Brunner-neutrino-lab/VUV4-carrier/pcb/vuv4x2/vuv4x3.step

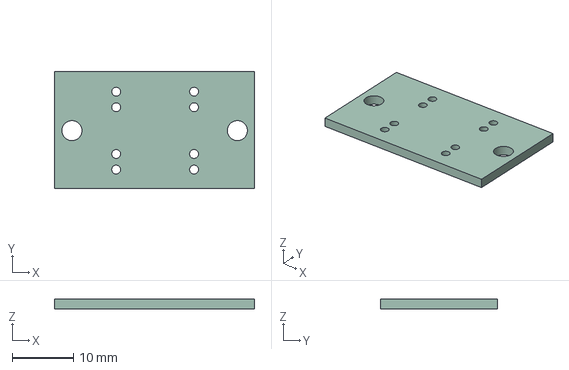
[picture p1: CAD file, 2023-06-26]
pcb/vuv4x2/vuv4x3.step
32.6 x 19.0 x 1.58 mm
