Brunner-neutrino-lab/VUV4-carrier/pcb/vuv4x2/vuv4x2.step

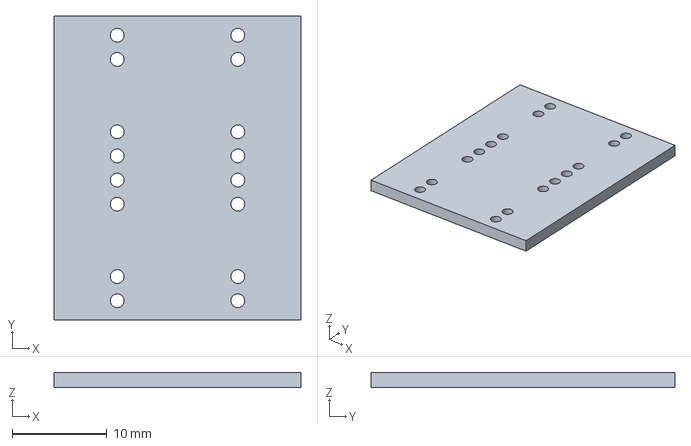
[picture p2: CAD file, 2023-05-21]
pcb/vuv4x2/vuv4x2.step
26.0 x 32.0 x 1.60 mm
