Brunner-neutrino-lab/VUV4-carrier/parts/Adam Tech MMCX SMT RF20-01B-L-00-50-G-TR.pdf

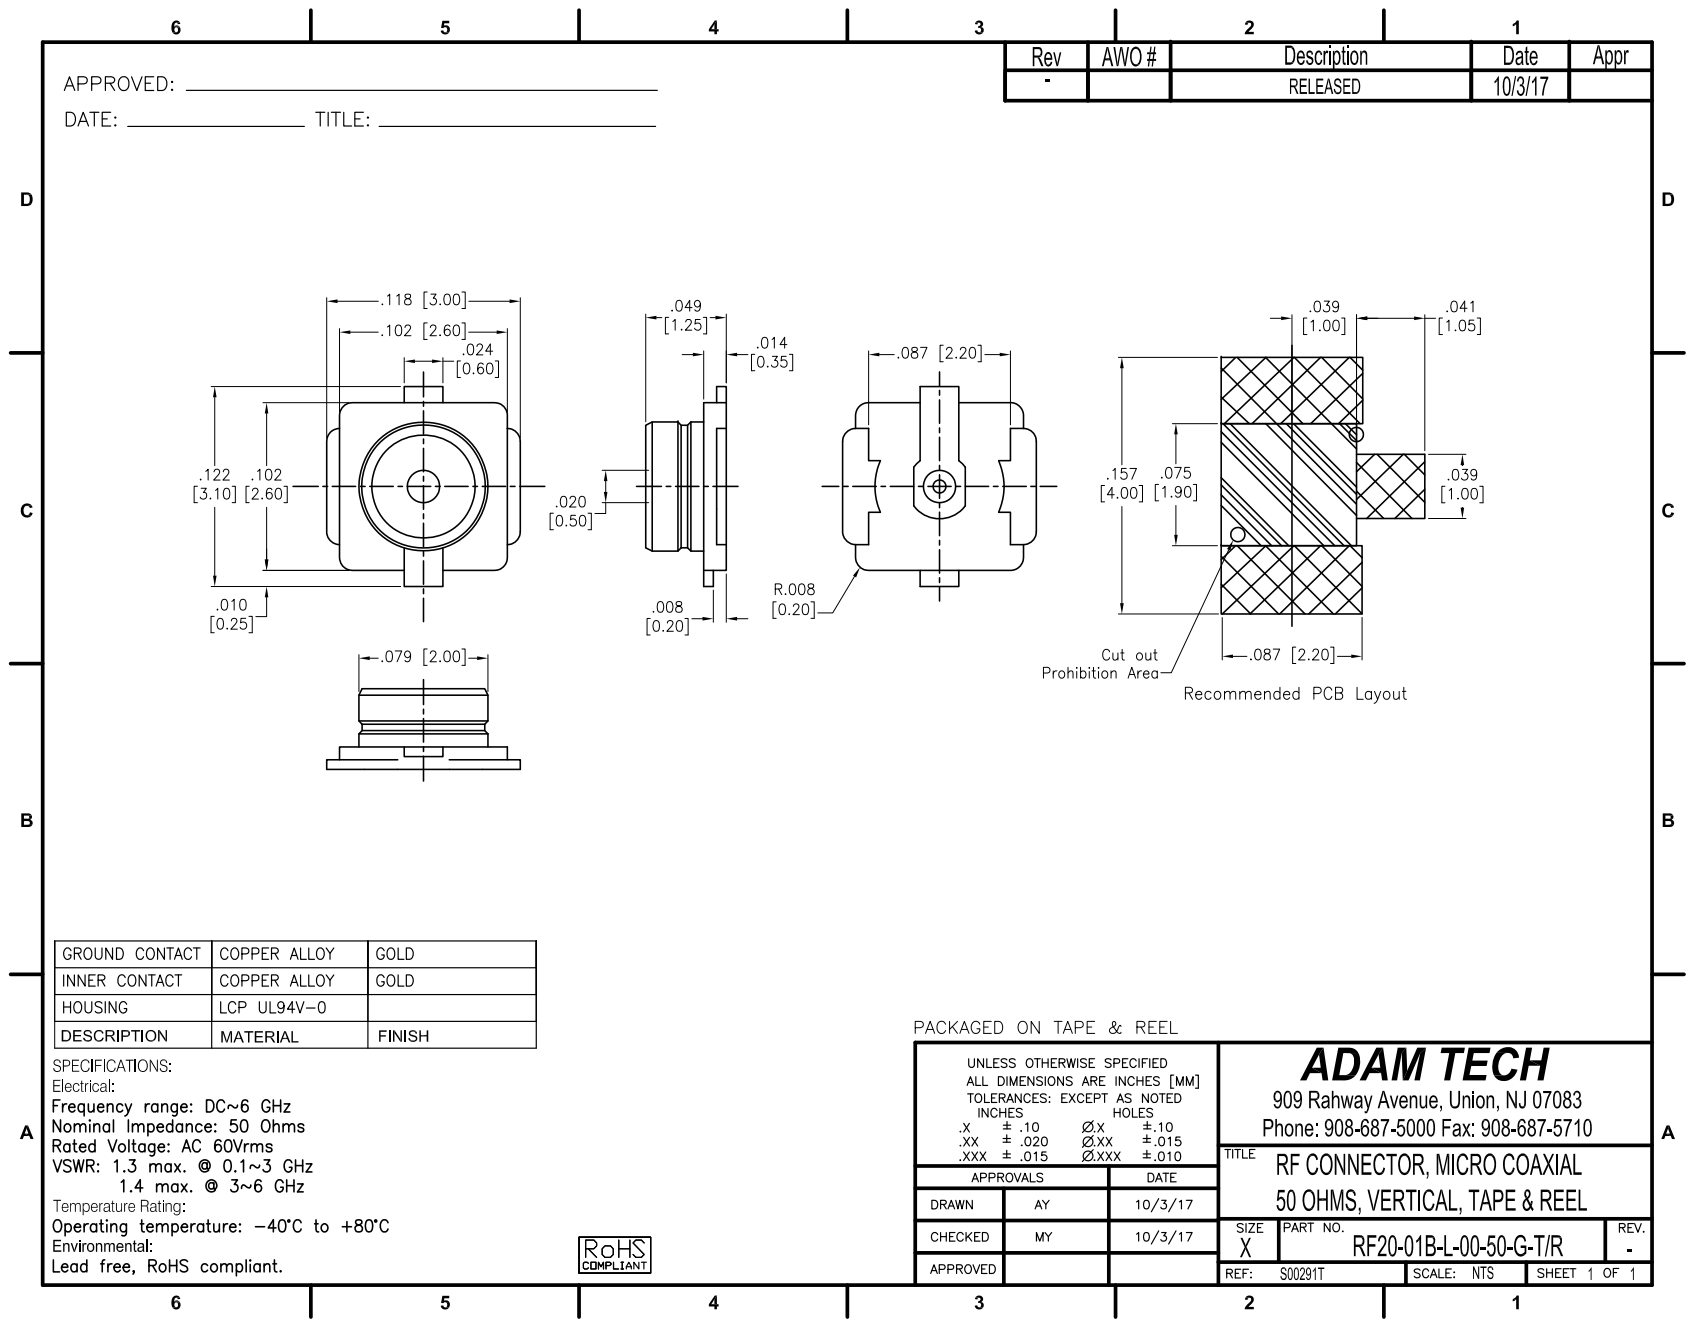
[picture p3: page 1]
