Brunner-neutrino-lab/VUV4-carrier/parts/Molex MMCX THT 734151472_sd.pdf

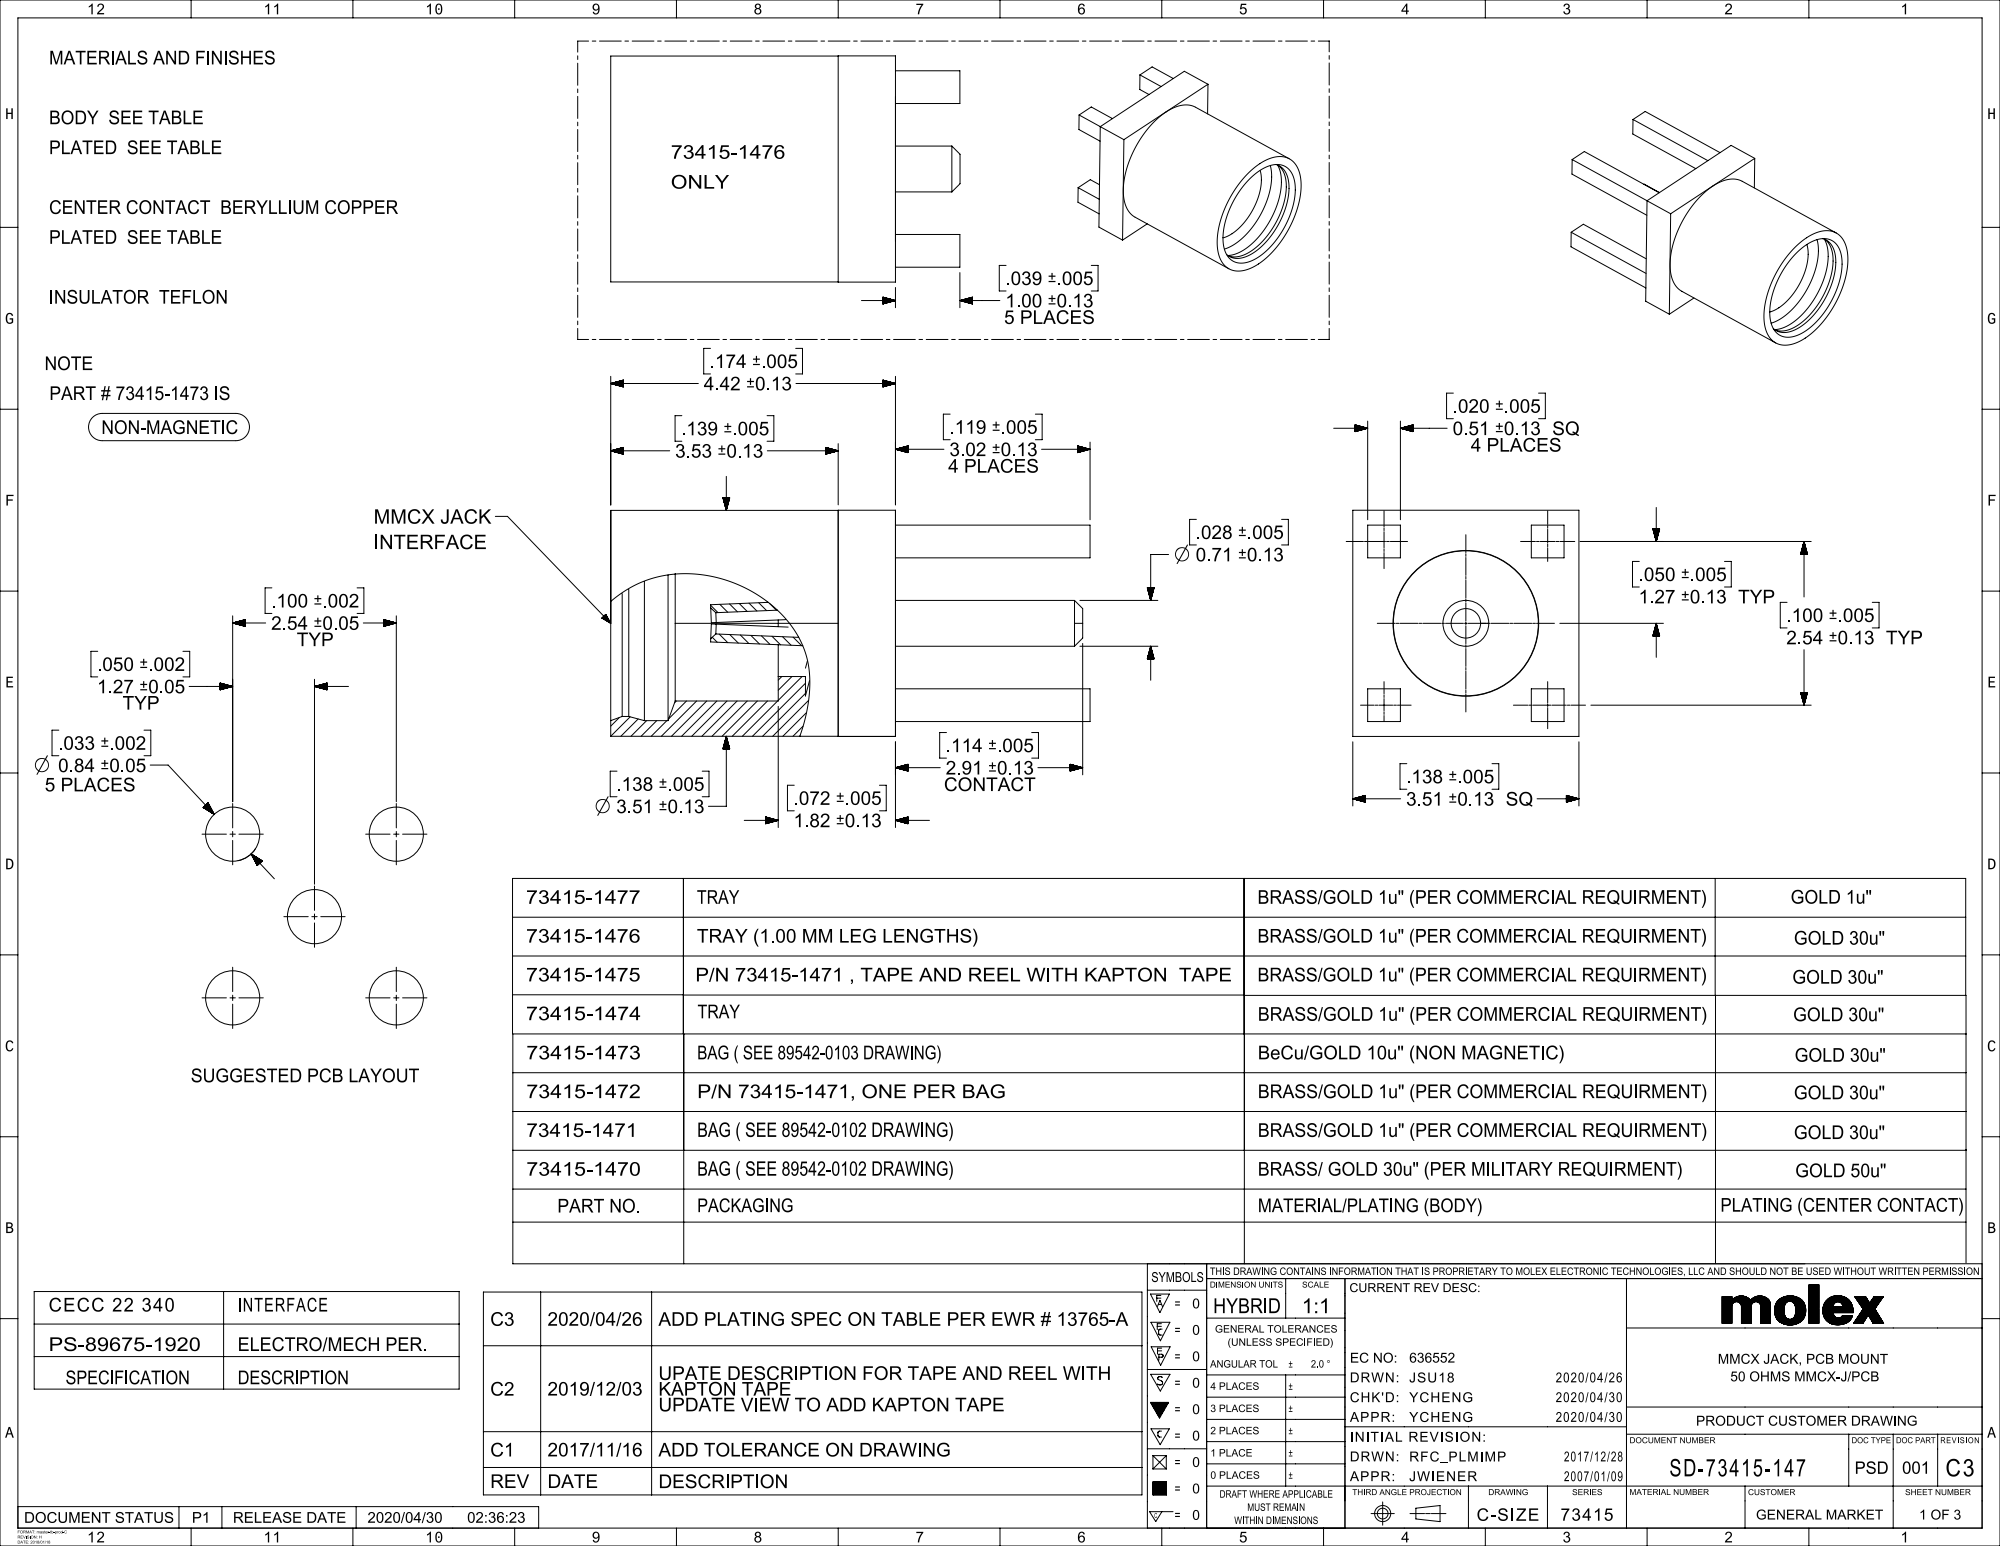
[picture p4: page 1]

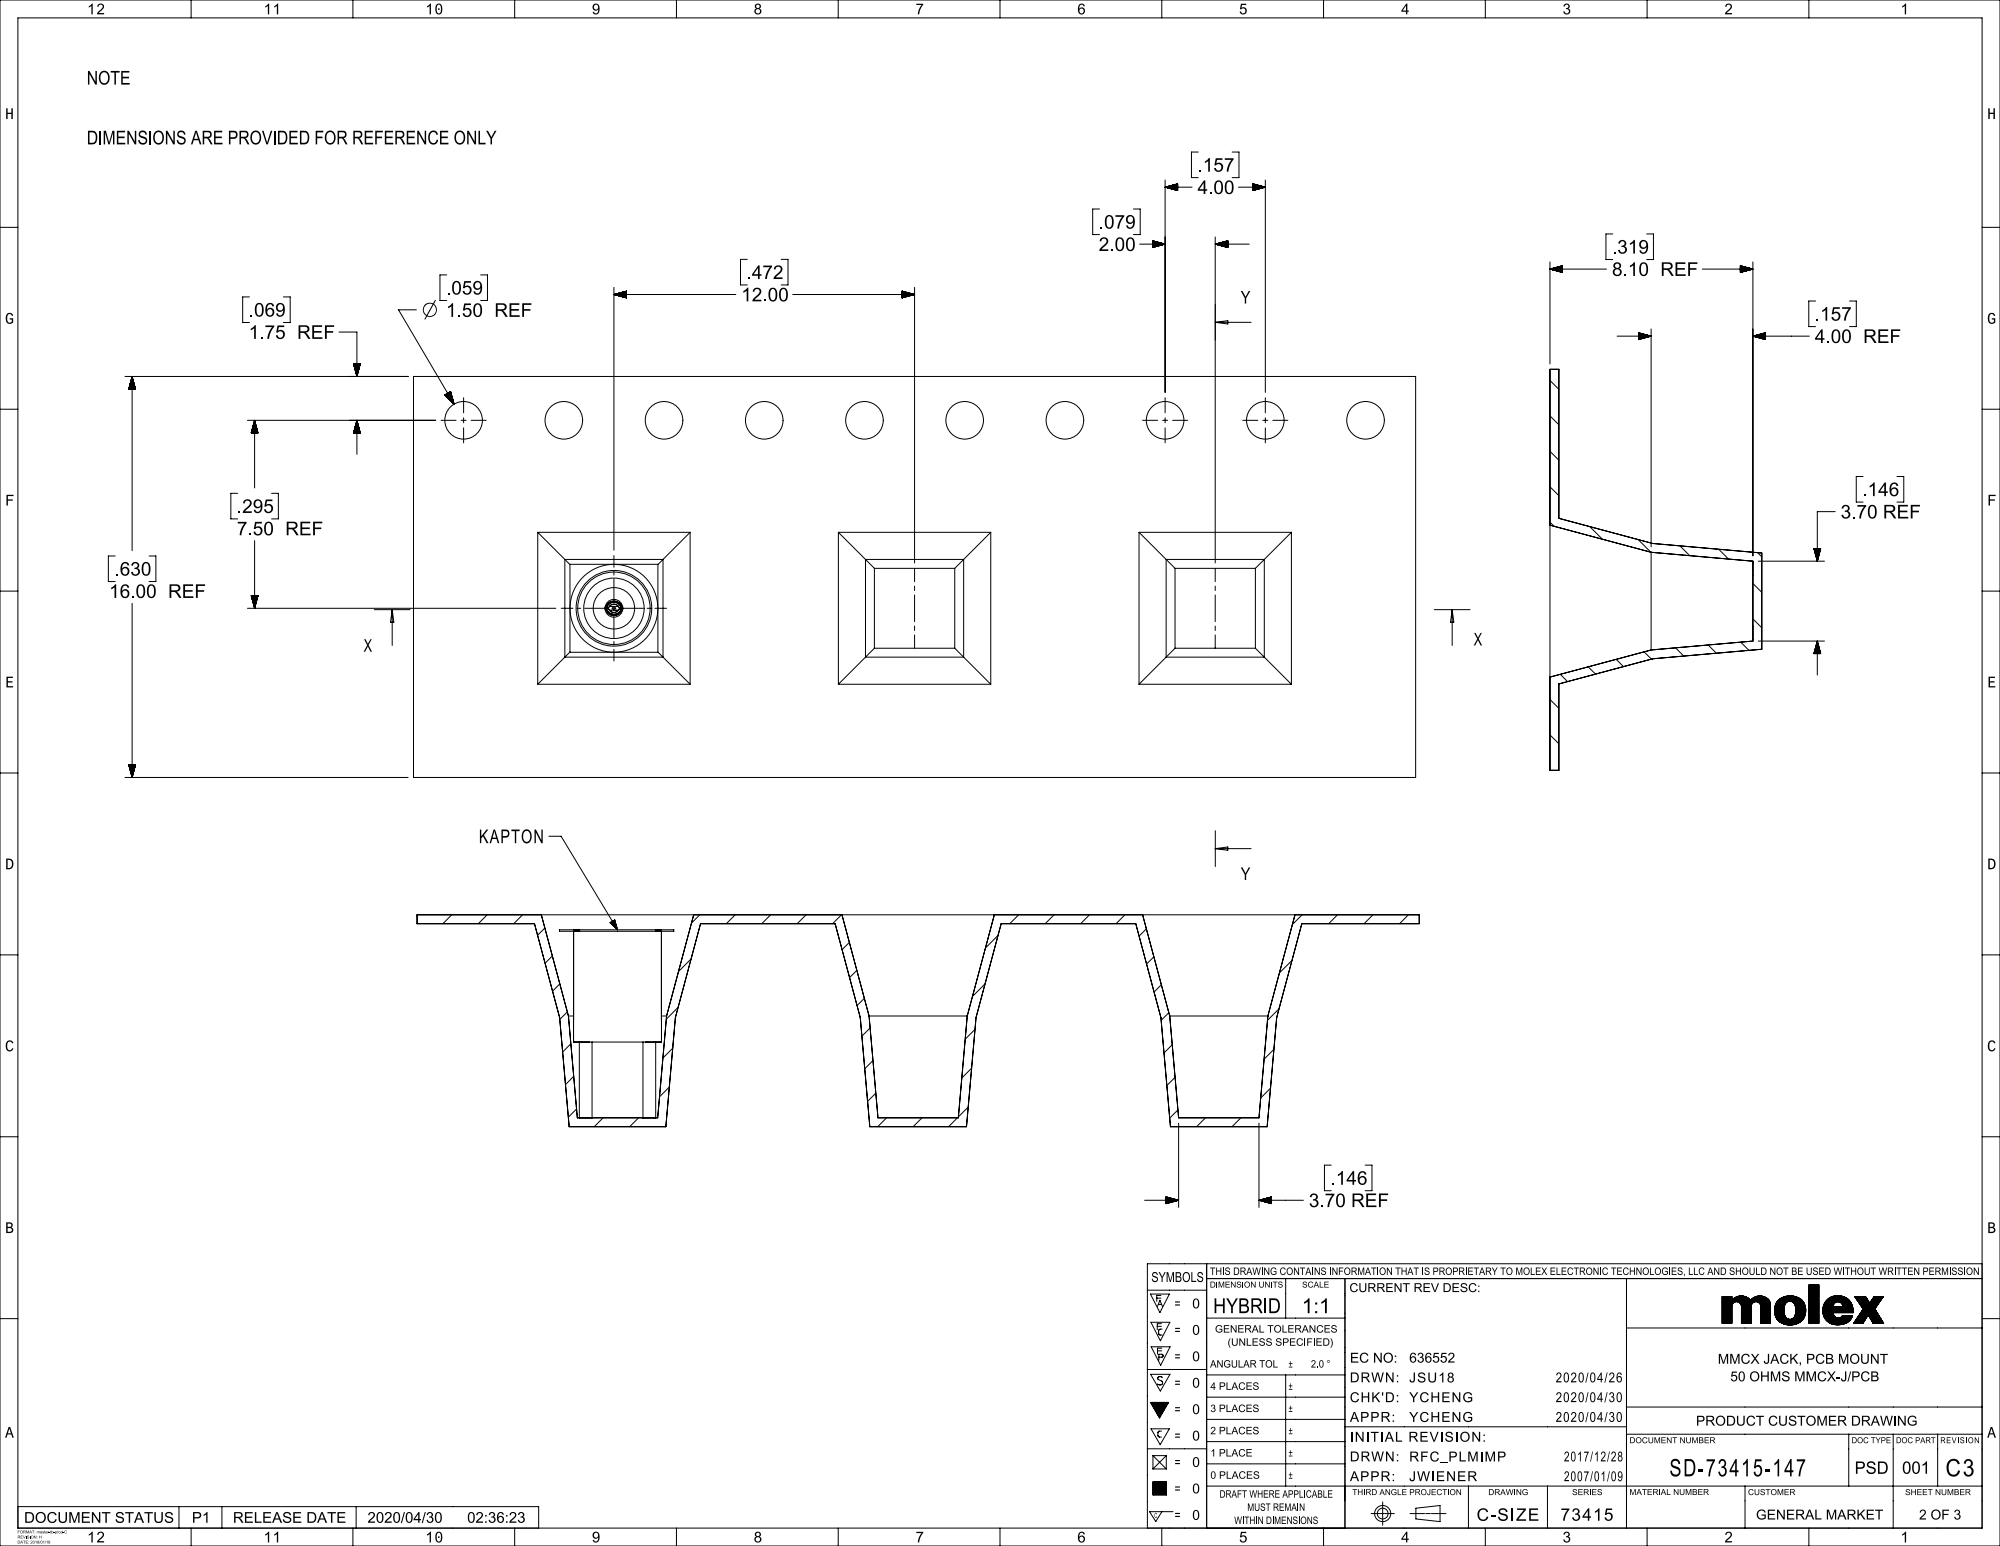
[picture p5: page 2]

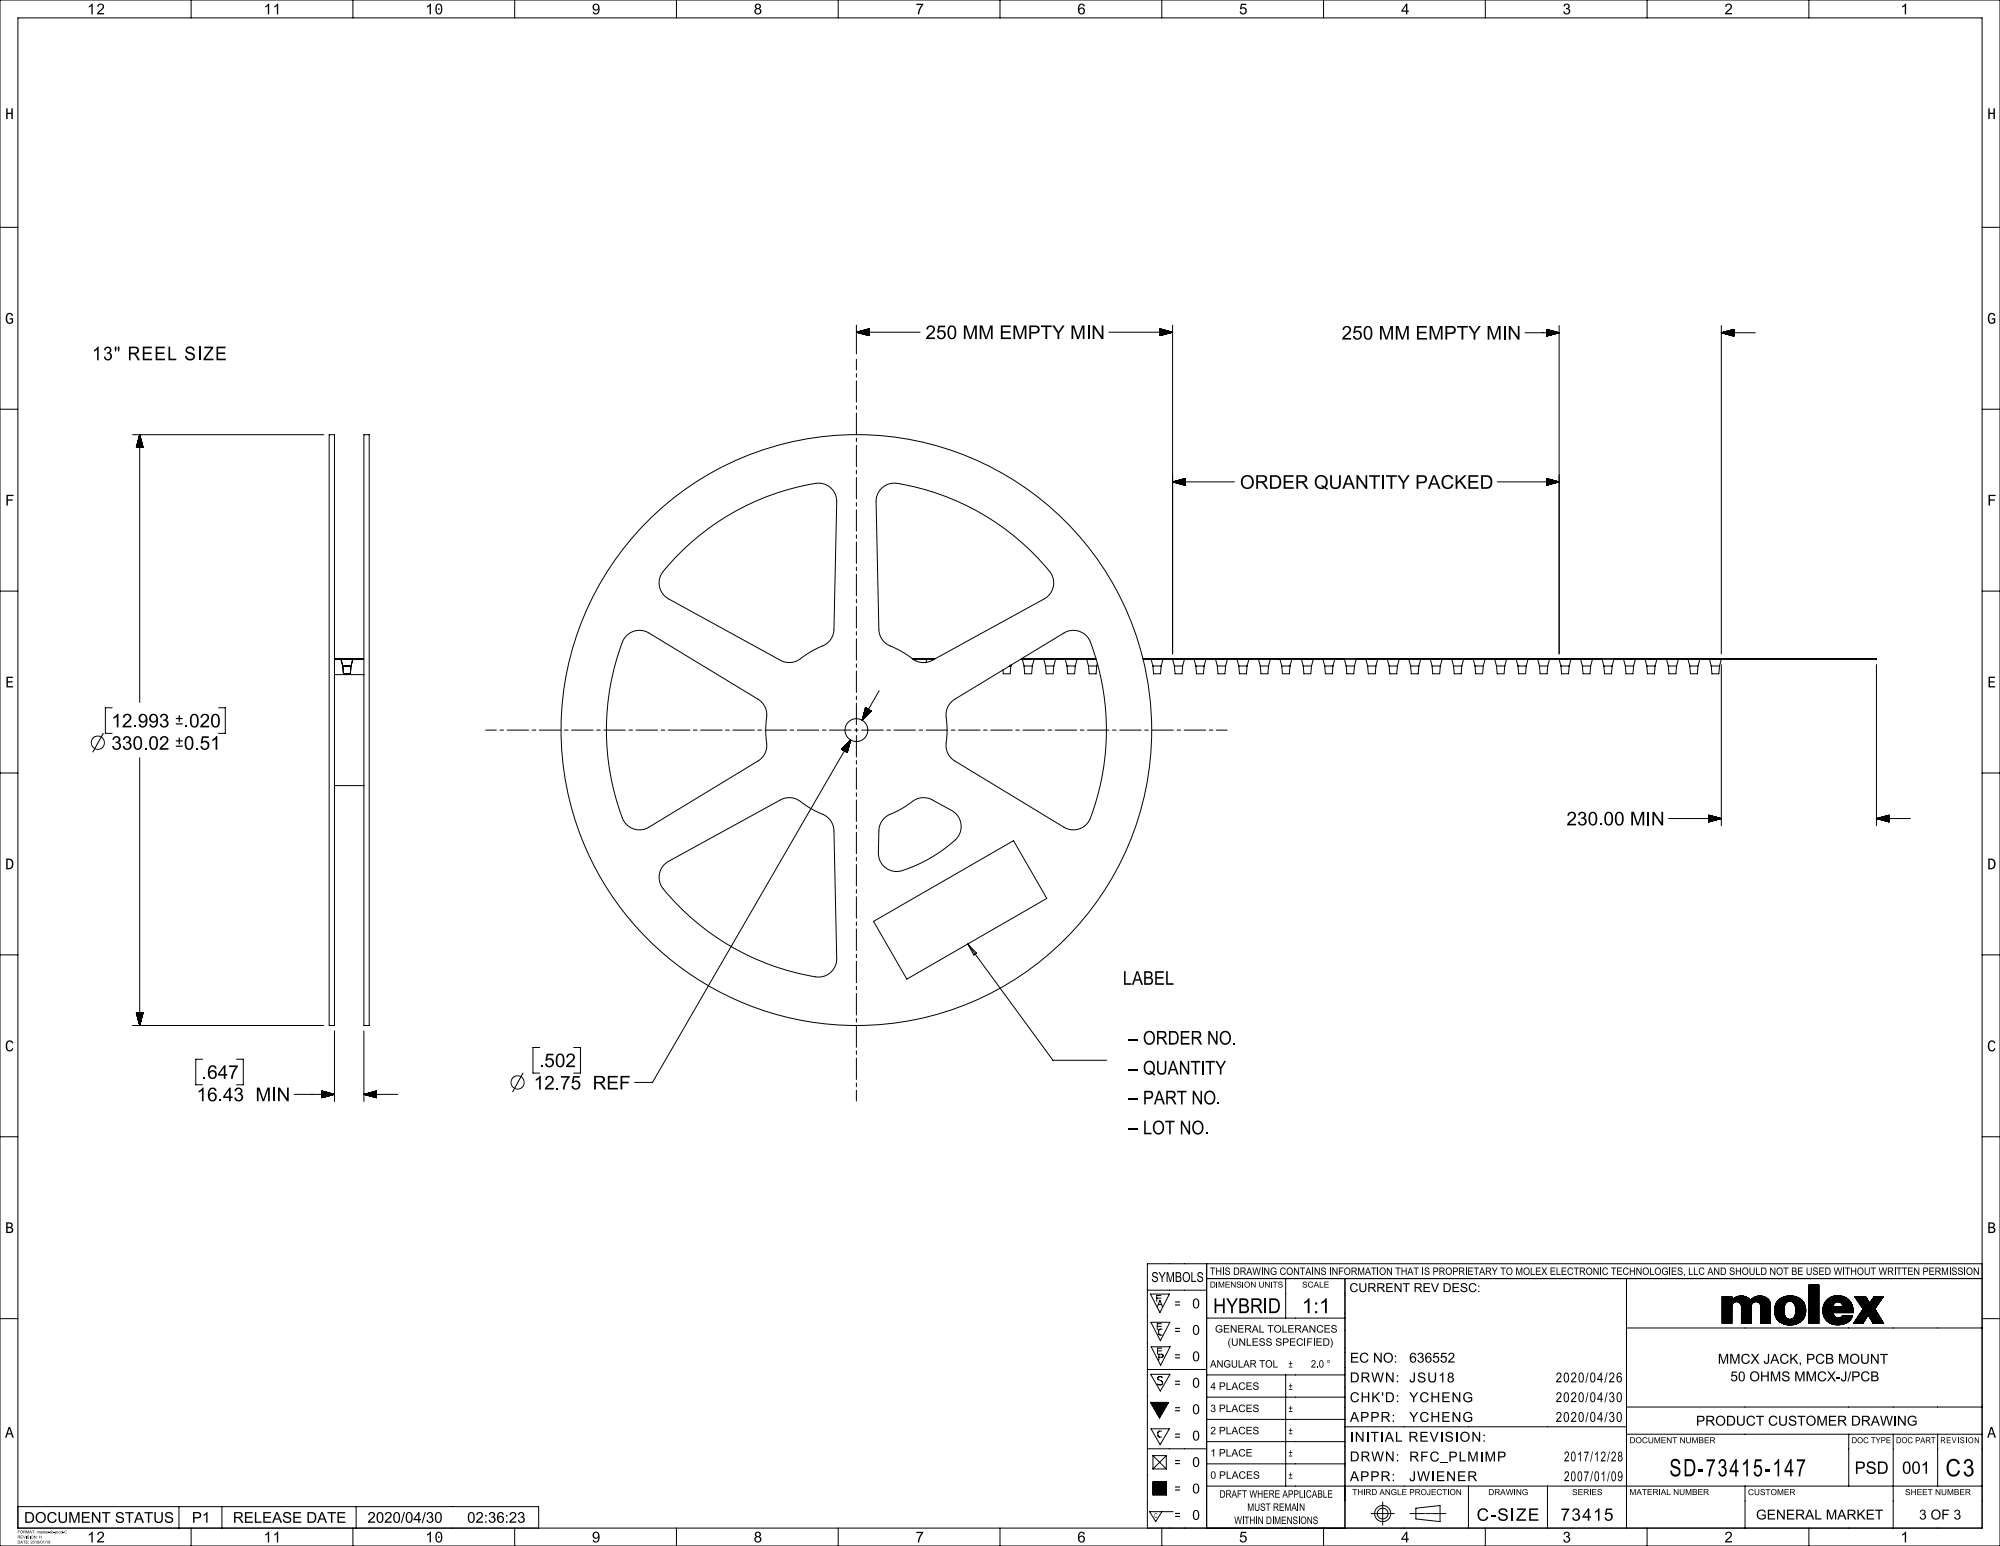
[picture p6: page 3]
