Brunner-neutrino-lab/VUV4-carrier/(commit log)

2023-05-21 PCB for VUV4 carrier board - initial upload. Includes two PCBs: first is a simple mount for two VUV4 quads, using U.Fl connectors. The second is a more complicated board for one VUV4 that includes gu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
    [vuv4-50q.kicad_pcb, vuv4-50q.kicad_sch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]
2023-06-23 Added vuv4x3 - single vuv4 carrier board with u.fl connectors and passive summing
    [vuv4-50q.kicad_pcb, vuv4-50q.kicad_sch, vuv4x3.kicad_pcb]
2023-06-23 Updated low-leakage mode to fit better inside of case
    [vuv4-50qx2.kicad_pcb, vuv4x3.kicad_pcb]
2023-06-26 added 3d files for pcb
    [vuv4x3.step]
